whitecider/BiometricLock/task.md

# Atomic Motion - Project Tasks

- [x] Create Wiring Guide (BOM and Connections.md)
- [x] Define Design Intent & Logic <!-- id: 0 -->
    - [x] Core Logic (Open/Close/Stall)
    - [x] Power Management (Deep Sleep)
    - [x] Web Interface Requirements (Fingerprint Registration)
- [x] Create Implementation Plan <!-- id: 1 -->
- [x] Develop Firmware <!-- id: 2 -->
    - [x] Core Motor Control & Safety
    - [x] Deep Sleep & Wake Logic
    - [x] Web Server & Fingerprint Management
    - [x] Motor Diagnostics (Web Control & Current Monitoring)
    - [x] Refine Stall Detection (Re-enable & Integrate)
- [/] Verification & Testing <!-- id: 3 -->
    - [/] Debug Fingerprint Enrollment
    - [ ] Verify Stall Protection
