whitecider/BiometricLock/Docs/0900766b80027e1f.pdf

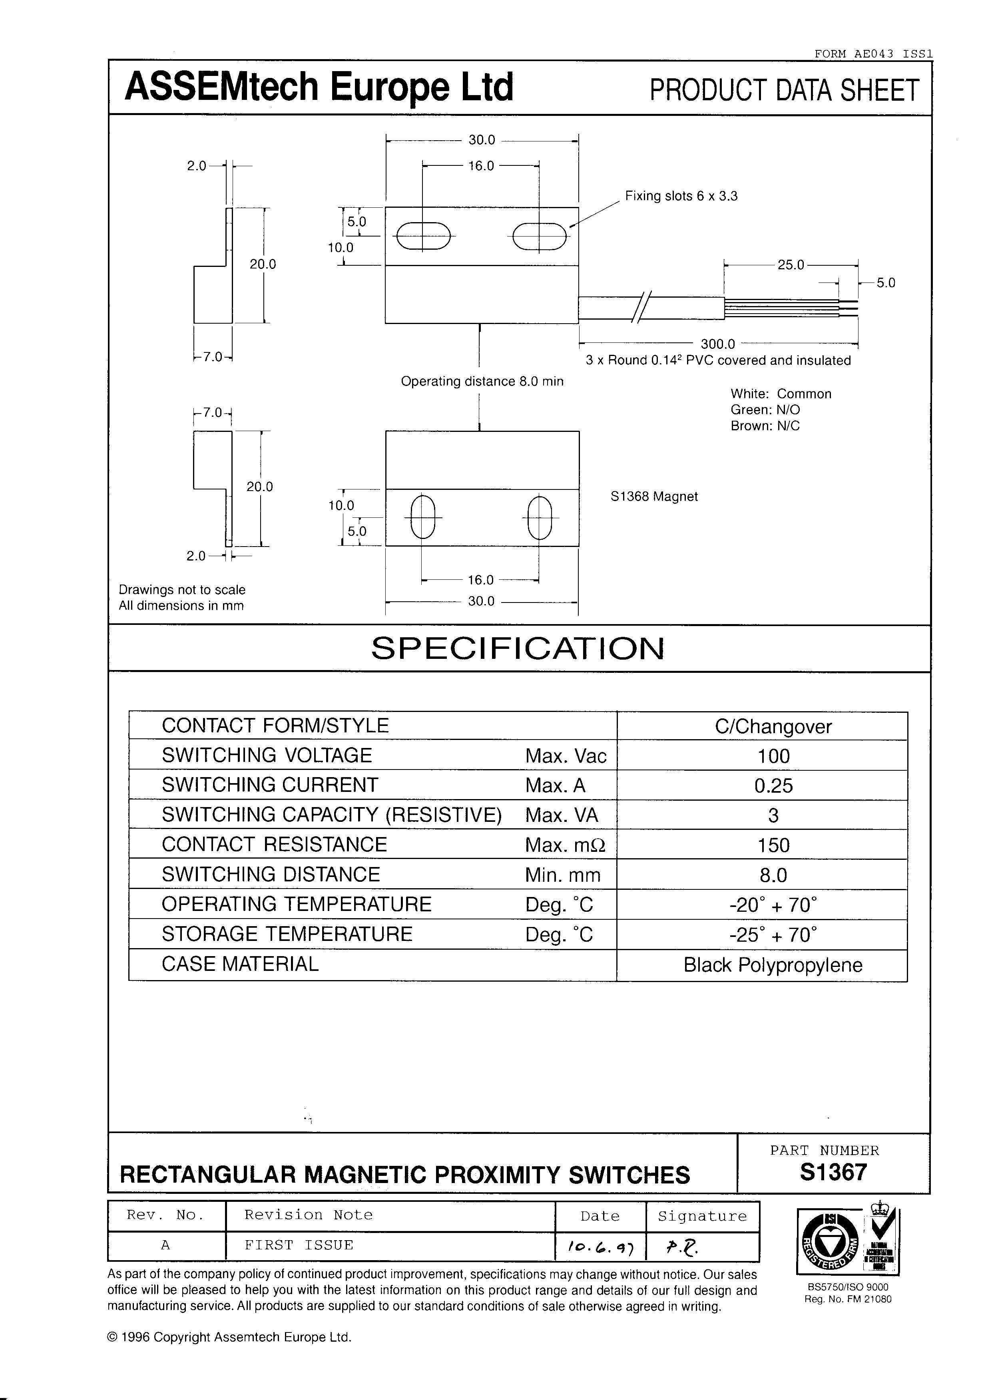
[picture p1: page 1]
