whitecider/BiometricLock/(commit log)

2026-02-10 Implement Serial Enrollment and Motor Diagnostics
    [partitions.csv]
2026-02-10 refactor: Replace servo with a DC motor, update associated documentation, and refine stall detection logic.
2026-02-10 feat: Add cable to BOM and implement a script for re-authoring git commits.
2026-02-10 chore: remove build directory and add .gitignore
    [partitions.csv]
